DrZedEau/NavBridge_CM4/hardware/NavBridge_CM4/production/bom.csv

Designator | Footprint | Quantity | Value | LCSC Part #
C1 | CP_Elec_6.3x5.8 | 1 | 100µ | C128464
C10, C7, C8, C9 | 1206 | 4 | 47µ | C96123
C11, C15, C29 | 0805 | 3 | 4.7µ | C1779
C12, C13, C14, C18, C19, C20, C21, C23, C24, C26, C27, C30, C32, C33, C34, C35, C37, C38, C39, C4, C40, C43, C44, C45, C47, C49, C5, C53, C6, C62 | 0402 | 30 | 100n | C307331
C16, C46, C48 | 0805 | 3 | 10µ | C15850
C17, C22 | 0402 | 2 | 10n | C15195
C2, C3 | 1206 | 2 | 4.7µ | C29823
C25, C31, C61 | 0402 | 3 | 4.7µ | C23733
C28 | 1206 | 1 | 10µ | C13585
C36, C52, C54, C55, C58, C63, C64, C65, C71 | 0402 | 9 | 1µ | C52923
C41, C42 | 0402 | 2 | 10p | C32949
C50, C51 | 1206 | 2 | 22µ | C12891
C56, C57 | 0402 | 2 | 22p | C1555
C59, C60 | 0402 | 2 | 100p | C1546
C66, C68 | CP_EIA-3528-21_Kemet-B | 2 | 100µ | C16133
C67, C69 | 0402 | 2 | 22n | C1532
C70 | 0603 | 1 | 10µ | C96446
C72 | 0603 | 1 | 10µ | C19702
CN1, CN2 | Hirose_DF40C-100DS-0.4V_2x50_P0.4mm | 2 | DF40C-100DS-0.4V | C597931
CN3 | C277636_CONN-TH_12P-P3_00-S3_00_L12_2-W21_7-EH10_7 | 1 | Molex 430451200 | C277636
CN4 | PinHeader_2x09_P2.54mm_Horizontal | 1 | X1313 Car connector | C492437
CN5 | C598547_IDC-SMD_10P-P1_27_X1270WVS-2X05B-6TV01 | 1 | 20021521-00010C1LF | C598547
CN6, CN7 | C2977809_PCIE-SMD_2199230-4 | 2 | 2199230-4_C2977809 | C2977809
CN8 | C161690_CONN-SMD_2P-P1_25_BM02B-GHS-TBT-LF-SN | 1 | BM02B-GHS-TBT (LF)(SN) | C161690
D1 | 0805 | 1 | LED_G | C2297
D2 | 0805 | 1 | LED_R | C84256
D3 | D_SMC | 1 | SMCJ24A | C19077604
D4 | D_SMA | 1 | SS54 | C22452
D5 | D_SOD-123 | 1 | 1N4148W | C81598
D6 | 0603 | 1 | LED_Y | C89811
FB1 | 0603 | 1 | FerriteBead | C14709
FH1 | C108518_FUSE-SMD_L9_8-W5_0_01550900M | 1 | 01550900M | C108518
J1 | USB_C_Receptacle_G-Switch_GT-USB-7010ASV | 1 | USB_C_Receptacle_USB2.0_16P | C2988369
L1 | L_Sunlord_MWSA1003S | 1 | 6.8uH | C2453947
L2 | L_Sunlord_MWSA0518S | 1 | 6.8uH | C2928918
L3 | 1008 | 1 | 1µH | C435392
R1, R16, R17, R18, R2, R40 | 0402 | 6 | 1k | C11702
R10 | 0603 | 1 | 560 | C23204
R11, R15, R19, R25, R26, R27, R28, R29, R3 | 0402 | 9 | 10k | C25744
R12, R13, R14 | 0402 | 3 | 75 | C25133
R20, R21, R22, R23, R42, R5 | 0402 | 6 | 100k | C25741
R24 | 0402 | 1 | 12K | C25752
R30, R31 | 0402 | 2 | 22 | C25092
R32 | 0402 | 1 | 1.5k | C25867
R33 | 0402 | 1 | 1M | C26083
R34, R35, R37, R38 | 0402 | 4 | 3.3k | C25890
R36, R39 | 0603 | 2 | 15 | C22810
R4 | 0402 | 1 | 49.9k | C25897
R6, R8, R9 | 0402 | 3 | 5.1k | C25905
R7 | 0402 | 1 | 18k | C25762
SW1 | C3312309_SW-SMD_NIDEC_CHS-01B1 | 1 | CHS-01B1 | C3312309
SW2 | SW_SPST_TS-1088-xR020 | 1 | SW_Push | C318884
SW3 | SW_SPST_TS-1088-xR020 | 1 | SW_Push | C720477
U1 | C514175_CONN-TH_SM03B-GHS-TB-LF-SN | 1 | SM03B-GHS | C514175
U10, U8 | C5225740_DFN-8_L3_0-W3_0-P0_65-BL-EP-1 | 2 | ATA663231-GBQW | C5225740
U11, U4 | C22399676_SOT-583-8_L2_1-W1_2-P0_50-LS1_6-BL | 2 | TPS2117DRLR | C22399676
U12 | C128396_UQFN-10_L2_0-W1_5-P0_50-BL | 1 | TS3USB221ARSER | C128396
U13 | C58940_TQFN-36_L6_0-W6_0-P0_50-BL-EP3_7 | 1 | USB2514BI-AEZG-TR | C58940
U14 | C475497_TQFP-32_L7_0-W7_0-P0_80-LS9_0-TL | 1 | PCM2912APJTR | C475497
U15 | C24593_SOT-23-5_L3_0-W1_7-P0_95-LS2_8-BR | 1 | TPS2051BDBVR | C24593
U16 | TSOT-23-6 | 1 | AP63203WU | C780769
U17 | C33770534_DFN-8_L3_0-W2_0-P0_50-BL-EP1_6 | 1 | MFI343S00177-L | C33770534
U18 | C5468341_FPC-SMD_22P-P0_50_0524352271 | 1 | 0524352271 | C5468341
U2 | C189893_CONN-SMD_SM02B-GHS-TB-LF-SN | 1 | SM02B-GHS | C189893
U3 | C485817_SO-8_L4_9-W3_9-P1_27-LS6_0-BL-EP | 1 | LMR14030SQDDARQ1 | C485817
U5 | C404027_SOT-23-5_L3_0-W1_7-P0_95-LS2_8-BR | 1 | TLV75533PDBVR | C404027
U6 | LQFP-48_L7.0-W7.0-P0.50-LS9.0-BL | 1 | ADV7125KSTZ140 | C9668
U7 | C2673443_TSSOP-16_L5_0-W4_4-P0_65-LS6_4-BL | 1 | TMUX1574PWR | C2673443
U9 | LQFP-32_7x7mm_P0.8mm | 1 | STM32C071KBTx | C42116633
Y1 | Crystal_SMD_2016-4Pin_2.0x1.6mm | 1 | Crystal_GND24 | C6616880
Y2 | Crystal_SMD_FOX_FQ7050-4Pin_7.0x5.0mm | 1 | 6MHz | C179631
