DrZedEau/NavBridge_CM4/hardware/NavBridge_CM4/NavBridge_CM4.kicad_pcb

## KiCad design hardware/NavBridge_CM4/NavBridge_CM4.kicad_pcb (2026-11-06)

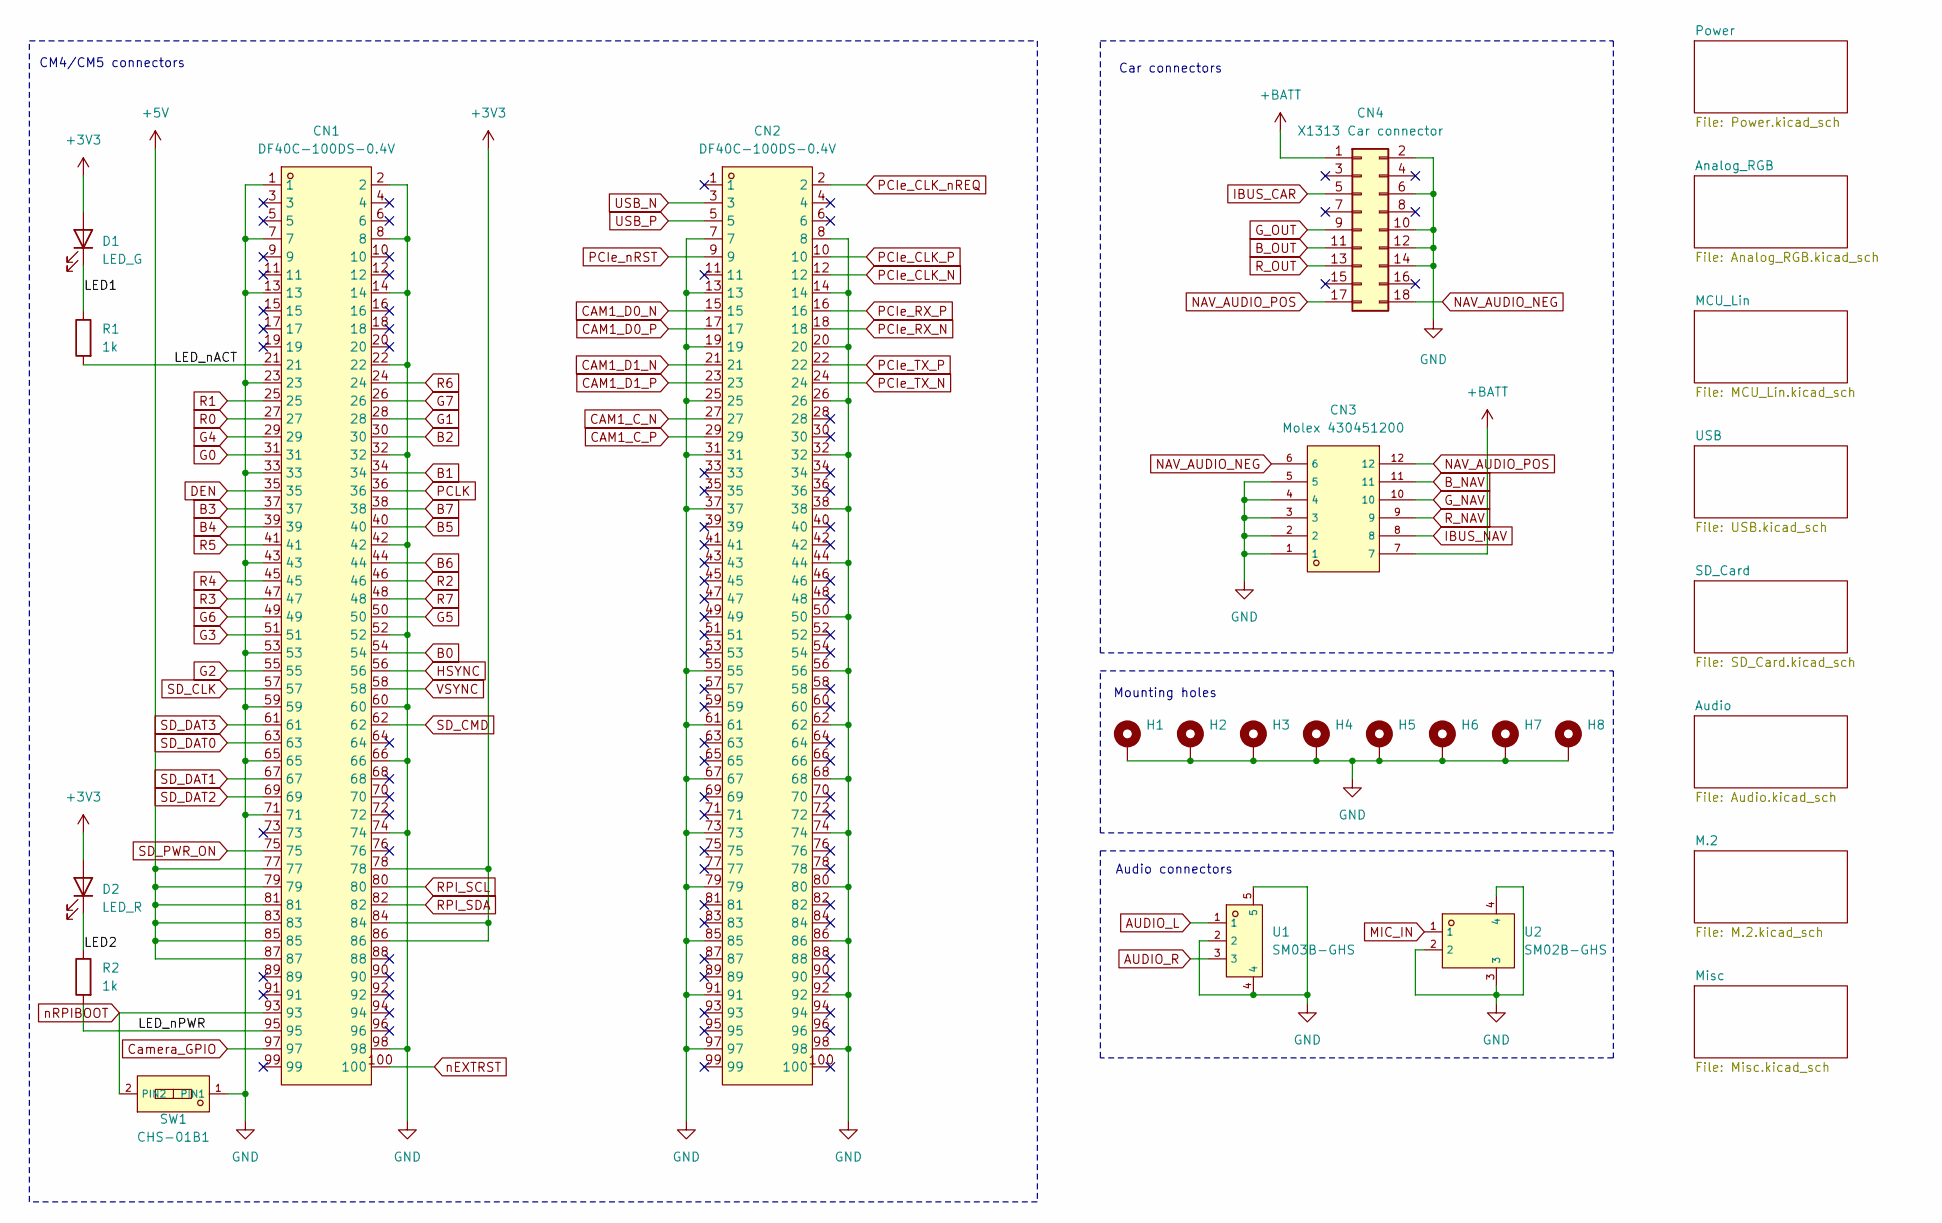
[picture p4: schematic NavBridge_CM4.kicad_sch, CM5_BMW_NavBridge]

Parts:
CN1, CN2: DF40C-100DS-0.4V; Hirose_DF40C-100DS-0.4V_2x50_P0.4mm; LCSC Part C597931
CN3: Molex 430451200; C277636_CONN-TH_12P-P3_00-S3_00_L12_2-W21_7-EH10_7; LCSC C277636
CN4: X1313 Car connector; PinHeader_2x09_P2.54mm_Horizontal; LCSC C492437
D1: LED_G; LED_0805_2012Metric; LCSC C2297
D2: LED_R; LED_0805_2012Metric; LCSC C84256
H1, H2, H3, H4, H5, H6, H7, H8: MountingHole_Pad; MountingHole_2.7mm_M2.5_Pad_TopBottom
R1, R2: 1k; R_0402_1005Metric; LCSC C11702
SW1: CHS-01B1; C3312309_SW-SMD_NIDEC_CHS-01B1; LCSC C3312309
U1: SM03B-GHS; C514175_CONN-TH_SM03B-GHS-TB-LF-SN; LCSC C514175
U2: SM02B-GHS; C189893_CONN-SMD_SM02B-GHS-TB-LF-SN; LCSC C189893

Connections:
+3V3: CN1.78, CN1.84, CN1.86, D1.2 (A), D2.2 (A); also elsewhere on the board
+5V: CN1.77, CN1.79, CN1.81, CN1.83, CN1.85, CN1.87; also elsewhere on the board
+BATT: CN3.7, CN4.1; also elsewhere on the board
/LED1: D1.1 (K), R1.1
/LED2: D2.1 (K), R2.1
/LED_nACT: CN1.21, R1.2
/LED_nPWR: CN1.95, R2.2
AUDIO_L: U1.1; also elsewhere on the board
AUDIO_R: U1.3; also elsewhere on the board
B0: CN1.54; also elsewhere on the board
B1: CN1.34; also elsewhere on the board
B2: CN1.30; also elsewhere on the board
B3: CN1.37; also elsewhere on the board
B4: CN1.39; also elsewhere on the board
B5: CN1.40; also elsewhere on the board
B6: CN1.44; also elsewhere on the board
B7: CN1.38; also elsewhere on the board
B_NAV: CN3.11; also elsewhere on the board
B_OUT: CN4.11; also elsewhere on the board
CAM1_C_N: CN2.27; also elsewhere on the board
CAM1_C_P: CN2.29; also elsewhere on the board
CAM1_D0_N: CN2.15; also elsewhere on the board
CAM1_D0_P: CN2.17; also elsewhere on the board
CAM1_D1_N: CN2.21; also elsewhere on the board
CAM1_D1_P: CN2.23; also elsewhere on the board
Camera_GPIO: CN1.97; also elsewhere on the board
DEN: CN1.35; also elsewhere on the board
G0: CN1.31; also elsewhere on the board
G1: CN1.28; also elsewhere on the board
G2: CN1.55; also elsewhere on the board
G3: CN1.51; also elsewhere on the board
G4: CN1.29; also elsewhere on the board
G5: CN1.50; also elsewhere on the board
G6: CN1.49; also elsewhere on the board
G7: CN1.26; also elsewhere on the board
GND: CN1.1, CN1.2, CN1.7, CN1.8, CN1.13, CN1.14, CN1.22, CN1.23, CN1.32, CN1.33, CN1.42, CN1.43, CN1.52, CN1.53, CN1.59, CN1.60, CN1.65, CN1.66, CN1.71, CN1.74, CN1.98, CN2.7, CN2.8, CN2.13, CN2.14, CN2.19, CN2.20, CN2.25, CN2.26, CN2.31, CN2.32, CN2.37, CN2.38, CN2.44, CN2.50, CN2.55, CN2.56, CN2.61, CN2.62, CN2.67, CN2.68, CN2.73, CN2.74, CN2.79, CN2.80, CN2.85, CN2.86, CN2.91, CN2.92, CN2.97, CN2.98, CN3.1, CN3.2, CN3.3, CN3.4, CN3.5, CN4.2, CN4.6, CN4.10, CN4.12, CN4.14, H1.1 (1_1), H2.1 (1_1), H3.1 (1_1), H4.1 (1_1), H5.1 (1_1), H6.1 (1_1), H7.1 (1_1), H8.1 (1_1), SW1.1 (PIN1), U1.2, U1.4, U1.5, U2.2, U2.3, U2.4; also elsewhere on the board
G_NAV: CN3.10; also elsewhere on the board
G_OUT: CN4.9; also elsewhere on the board
HSYNC: CN1.56; also elsewhere on the board
IBUS_CAR: CN4.5; also elsewhere on the board
IBUS_NAV: CN3.8; also elsewhere on the board
MIC_IN: U2.1; also elsewhere on the board
NAV_AUDIO_NEG: CN3.6, CN4.18
NAV_AUDIO_POS: CN3.12, CN4.17
PCIe_CLK_N: CN2.12; also elsewhere on the board
PCIe_CLK_P: CN2.10; also elsewhere on the board
PCIe_CLK_nREQ: CN2.2; also elsewhere on the board
PCIe_RX_N: CN2.18; also elsewhere on the board
PCIe_RX_P: CN2.16; also elsewhere on the board
PCIe_TX_N: CN2.24; also elsewhere on the board
PCIe_TX_P: CN2.22; also elsewhere on the board
PCIe_nRST: CN2.9; also elsewhere on the board
PCLK: CN1.36; also elsewhere on the board
R0: CN1.27; also elsewhere on the board
R1: CN1.25; also elsewhere on the board
R2: CN1.46; also elsewhere on the board
R3: CN1.47; also elsewhere on the board
R4: CN1.45; also elsewhere on the board
R5: CN1.41; also elsewhere on the board
R6: CN1.24; also elsewhere on the board
R7: CN1.48; also elsewhere on the board
RPI_SCL: CN1.80; also elsewhere on the board
RPI_SDA: CN1.82; also elsewhere on the board
R_NAV: CN3.9; also elsewhere on the board
R_OUT: CN4.13; also elsewhere on the board
SD_CLK: CN1.57
SD_CMD: CN1.62
SD_DAT0: CN1.63
SD_DAT1: CN1.67
SD_DAT2: CN1.69
SD_DAT3: CN1.61
SD_PWR_ON: CN1.75
USB_N: CN2.3; also elsewhere on the board
USB_P: CN2.5; also elsewhere on the board
VSYNC: CN1.58; also elsewhere on the board
nEXTRST: CN1.100; also elsewhere on the board
nRPIBOOT: CN1.93, SW1.2 (PIN2); also elsewhere on the board

Notes on the sheet:
Car connectors
Audio connectors
CM4/CM5 connectors
Mounting holes

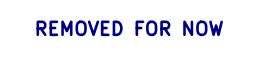
[picture p5: schematic SD_Card.kicad_sch]

Notes on the sheet:
REMOVED FOR NOW

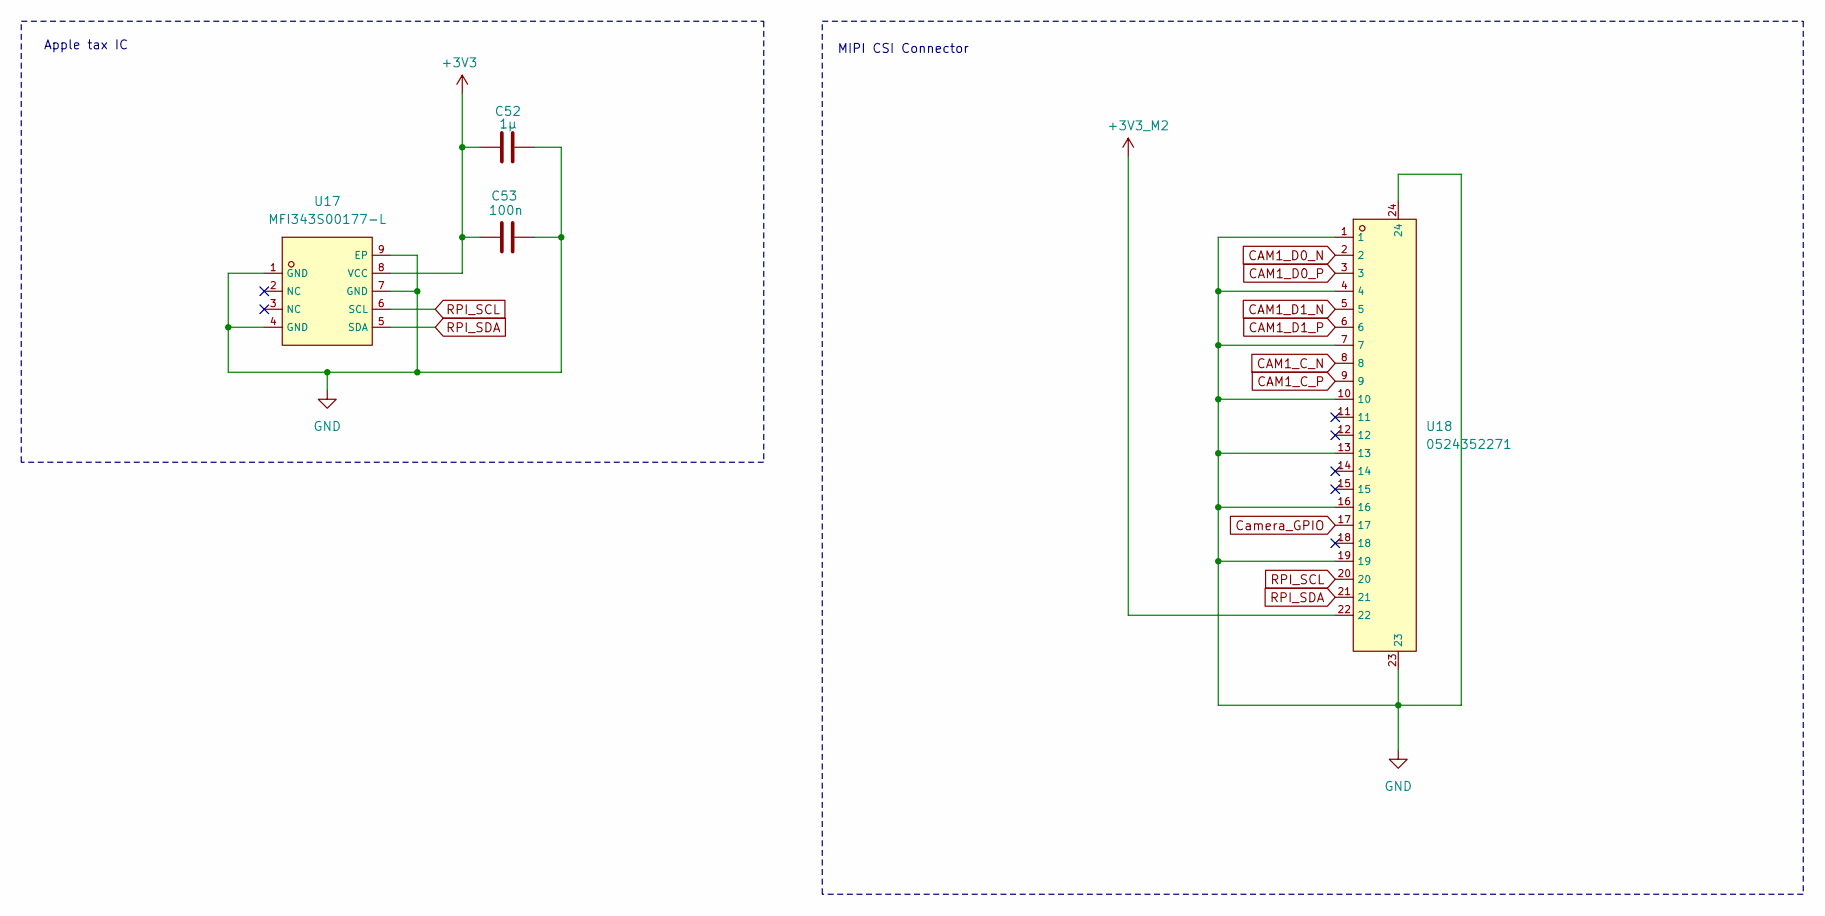
[picture p6: schematic Misc.kicad_sch]

Parts:
C52: 1µ; C_0402_1005Metric; LCSC C52923
C53: 100n; C_0402_1005Metric; LCSC C307331
U17: MFI343S00177-L; C33770534_DFN-8_L3_0-W2_0-P0_50-BL-EP1_6; LCSC C33770534
U18: 0524352271; C5468341_FPC-SMD_22P-P0_50_0524352271; LCSC C5468341

Connections:
+3V3: C52.1, C53.1, U17.8 (VCC); also elsewhere on the board
+3V3_M2: U18.22; also elsewhere on the board
CAM1_C_N: U18.8; also elsewhere on the board
CAM1_C_P: U18.9; also elsewhere on the board
CAM1_D0_N: U18.2; also elsewhere on the board
CAM1_D0_P: U18.3; also elsewhere on the board
CAM1_D1_N: U18.5; also elsewhere on the board
CAM1_D1_P: U18.6; also elsewhere on the board
Camera_GPIO: U18.17; also elsewhere on the board
GND: C52.2, C53.2, U17.1 (GND), U17.4 (GND), U17.7 (GND), U17.9 (EP), U18.1, U18.4, U18.7, U18.10, U18.13, U18.16, U18.19, U18.23, U18.24; also elsewhere on the board
RPI_SCL: U17.6 (SCL), U18.20; also elsewhere on the board
RPI_SDA: U17.5 (SDA), U18.21; also elsewhere on the board

Notes on the sheet:
Apple tax IC
MIPI CSI Connector

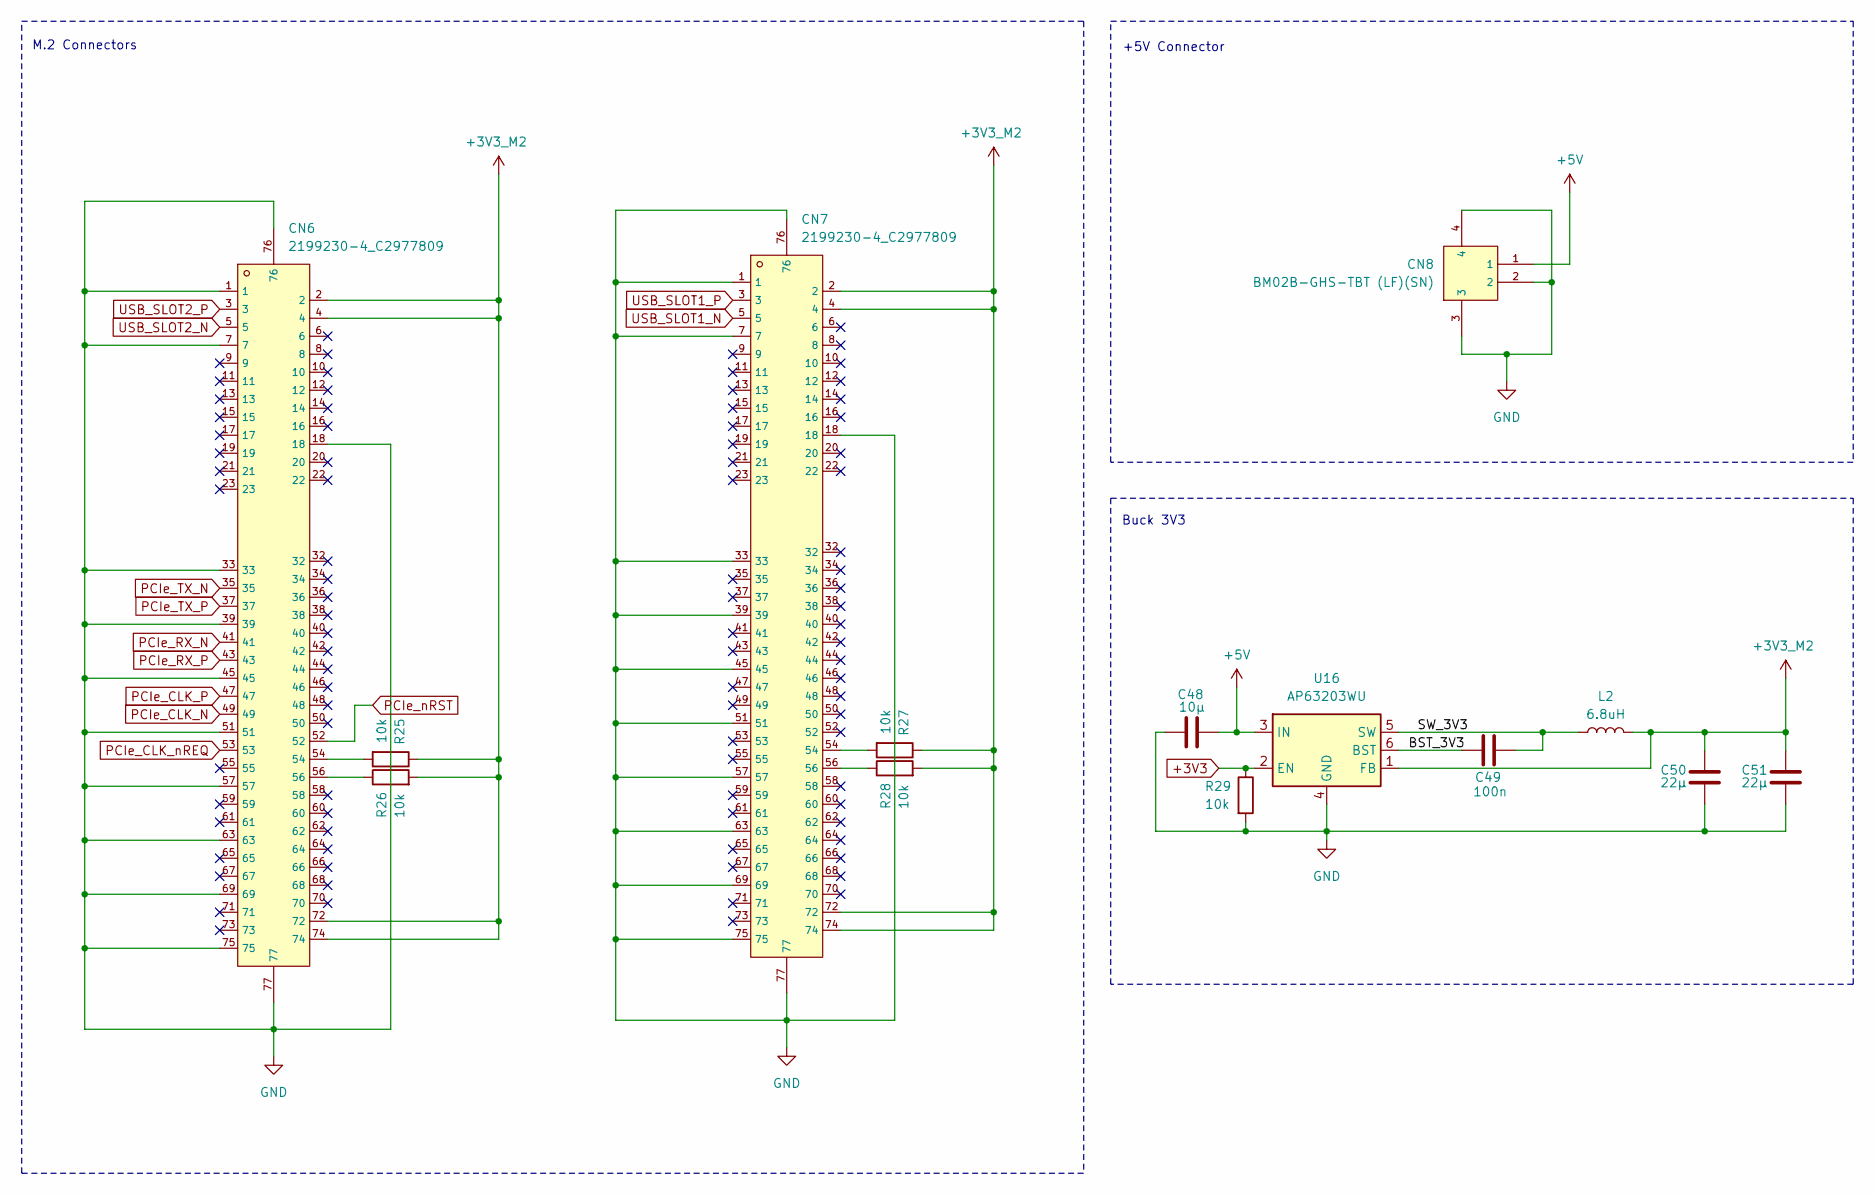
[picture p7: schematic M.2.kicad_sch]

Parts:
C48: 10µ; C_0805_2012Metric; LCSC C15850
C49: 100n; C_0402_1005Metric; LCSC C307331
C50, C51: 22µ; C_1206_3216Metric; LCSC C12891
CN6, CN7: 2199230-4_C2977809; C2977809_PCIE-SMD_2199230-4; LCSC C2977809
CN8: BM02B-GHS-TBT (LF)(SN); C161690_CONN-SMD_2P-P1_25_BM02B-GHS-TBT-LF-SN; LCSC C161690
L2: 6.8uH; L_Sunlord_MWSA0518S; LCSC C2928918
R25, R26, R27, R28, R29: 10k; R_0402_1005Metric; LCSC C25744
U16: AP63203WU; TSOT-23-6; LCSC C780769

Connections:
+3V3: R29.1, U16.2 (EN); also elsewhere on the board
+3V3_M2: C50.1, C51.1, CN6.2, CN6.4, CN6.72, CN6.74, CN7.2, CN7.4, CN7.72, CN7.74, L2.2, R25.1, R26.2, R27.1, R28.2, U16.1 (FB); also elsewhere on the board
+5V: C48.2, CN8.1, U16.3 (IN); also elsewhere on the board
/M.2/BST_3V3: C49.1, U16.6 (BST)
/M.2/SW_3V3: C49.2, L2.1, U16.5 (SW)
GND: C48.1, C50.2, C51.2, CN6.1, CN6.7, CN6.18, CN6.33, CN6.39, CN6.45, CN6.51, CN6.57, CN6.63, CN6.69, CN6.75, CN6.76, CN6.77, CN7.1, CN7.7, CN7.18, CN7.33, CN7.39, CN7.45, CN7.51, CN7.57, CN7.63, CN7.69, CN7.75, CN7.76, CN7.77, CN8.2, CN8.3, CN8.4, R29.2, U16.4 (GND); also elsewhere on the board
unnamed: CN6.54, R25.2
unnamed: CN6.56, R26.1
unnamed: CN7.54, R27.2
unnamed: CN7.56, R28.1
PCIe_CLK_N: CN6.49; also elsewhere on the board
PCIe_CLK_P: CN6.47; also elsewhere on the board
PCIe_CLK_nREQ: CN6.53; also elsewhere on the board
PCIe_RX_N: CN6.41; also elsewhere on the board
PCIe_RX_P: CN6.43; also elsewhere on the board
PCIe_TX_N: CN6.35; also elsewhere on the board
PCIe_TX_P: CN6.37; also elsewhere on the board
PCIe_nRST: CN6.52; also elsewhere on the board
USB_SLOT1_N: CN7.5; also elsewhere on the board
USB_SLOT1_P: CN7.3; also elsewhere on the board
USB_SLOT2_N: CN6.5; also elsewhere on the board
USB_SLOT2_P: CN6.3; also elsewhere on the board

Notes on the sheet:
M.2 Connectors
Buck 3V3
+5V Connector

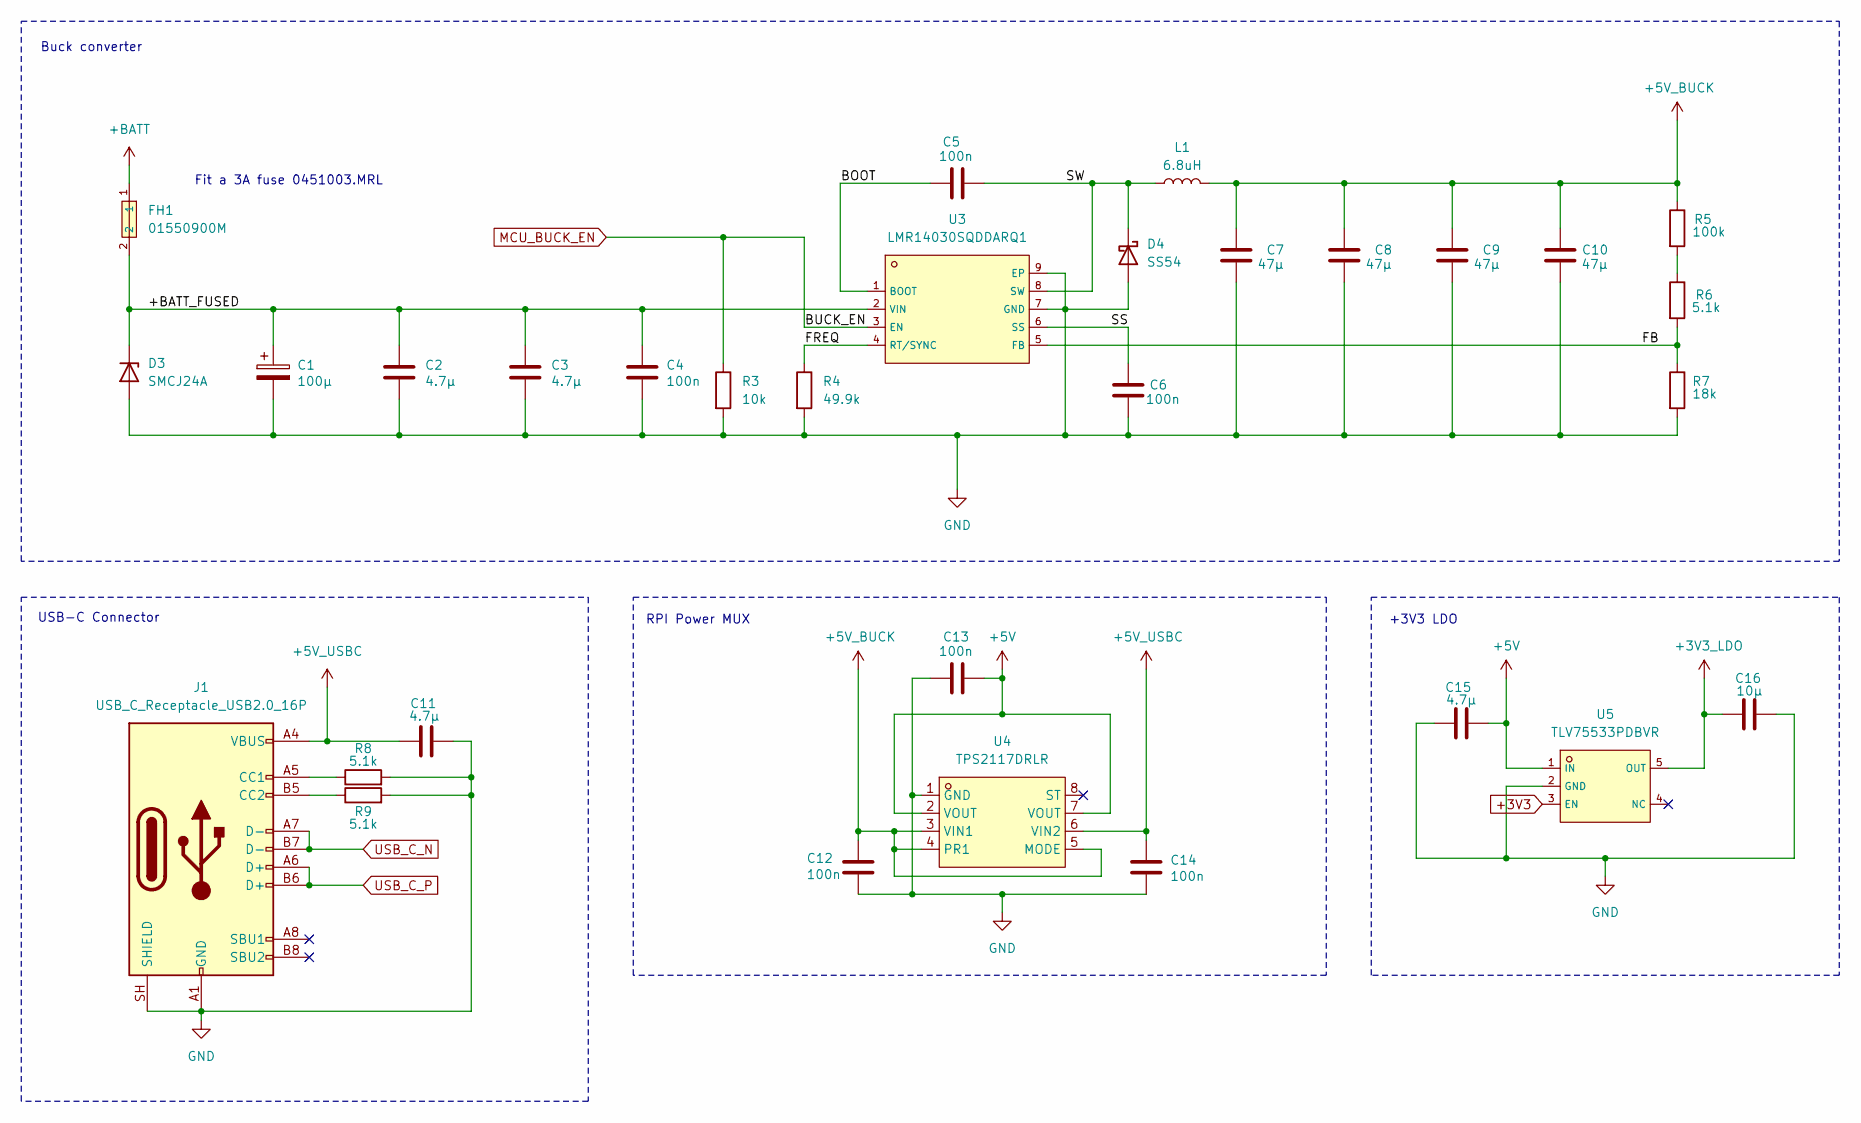
[picture p8: schematic Power.kicad_sch]

Parts:
C1: 100µ; CP_Elec_6.3x5.8; LCSC C128464
C2, C3: 4.7µ; C_1206_3216Metric; LCSC C29823
C4, C5, C6, C12, C13, C14: 100n; C_0402_1005Metric; LCSC C307331
C7, C8, C9, C10: 47µ; C_1206_3216Metric; LCSC C96123
C11, C15: 4.7µ; C_0805_2012Metric; LCSC C1779
C16: 10µ; C_0805_2012Metric; LCSC C15850
D3: SMCJ24A; D_SMC; LCSC C19077604
D4: SS54; D_SMA; LCSC C22452
FH1: 01550900M; C108518_FUSE-SMD_L9_8-W5_0_01550900M; LCSC C108518
J1: USB_C_Receptacle_USB2.0_16P; USB_C_Receptacle_G-Switch_GT-USB-7010ASV; LCSC C2988369
L1: 6.8uH; L_Sunlord_MWSA1003S; LCSC C2453947
R3: 10k; R_0402_1005Metric; LCSC C25744
R4: 49.9k; R_0402_1005Metric; LCSC C25897
R5: 100k; R_0402_1005Metric; LCSC C25741
R6, R8, R9: 5.1k; R_0402_1005Metric; LCSC C25905
R7: 18k; R_0402_1005Metric; LCSC C25762
U3: LMR14030SQDDARQ1; C485817_SO-8_L4_9-W3_9-P1_27-LS6_0-BL-EP; LCSC C485817
U4: TPS2117DRLR; C22399676_SOT-583-8_L2_1-W1_2-P0_50-LS1_6-BL; LCSC Part C22399676
U5: TLV75533PDBVR; C404027_SOT-23-5_L3_0-W1_7-P0_95-LS2_8-BR; LCSC C404027

Connections:
+3V3: U5.3 (EN); also elsewhere on the board
+3V3_LDO: C16.1, U5.5 (OUT); also elsewhere on the board
+5V: C13.2, C15.2, U4.2 (VOUT), U4.7 (VOUT), U5.1 (IN); also elsewhere on the board
+5V_BUCK: C7.1, C8.1, C9.1, C10.1, C12.1, L1.2, R5.1, U4.3 (VIN1), U4.4 (PR1), U4.5 (MODE)
+5V_USBC: C11.1, C14.1, J1.A4 (VBUS), J1.A9 (VBUS), J1.B4 (VBUS), J1.B9 (VBUS), U4.6 (VIN2)
+BATT: FH1.1; also elsewhere on the board
/Power/+BATT_FUSED: C1.1, C2.1, C3.1, C4.1, D3.1 (K), FH1.2, U3.2 (VIN)
/Power/BOOT: C5.1, U3.1 (BOOT)
/Power/FB: R6.2, R7.1, U3.5 (FB)
/Power/FREQ: R4.1, U3.4 (RT/SYNC)
/Power/SS: C6.1, U3.6 (SS)
/Power/SW: C5.2, D4.1 (K), L1.1, U3.8 (SW)
GND: C1.2, C2.2, C3.2, C4.2, C6.2, C7.2, C8.2, C9.2, C10.2, C11.2, C12.2, C13.1, C14.2, C15.1, C16.2, D3.2 (A), D4.2 (A), J1.A1 (GND), J1.A12 (GND), J1.B1 (GND), J1.B12 (GND), J1.SH (SHIELD), R3.2, R4.2, R7.2, R8.2, R9.2, U3.7 (GND), U3.9 (EP), U4.1 (GND), U5.2 (GND); also elsewhere on the board
MCU_BUCK_EN: R3.1, U3.3 (EN); also elsewhere on the board
unnamed: J1.A5 (CC1), R8.1
unnamed: J1.B5 (CC2), R9.1
unnamed: R5.2, R6.1
USB_C_N: J1.A7 (D-), J1.B7 (D-); also elsewhere on the board
USB_C_P: J1.A6 (D+), J1.B6 (D+); also elsewhere on the board

Notes on the sheet:
Buck converter
Fit a 3A fuse 0451003.MRL
USB-C Connector
RPI Power MUX
+3V3 LDO

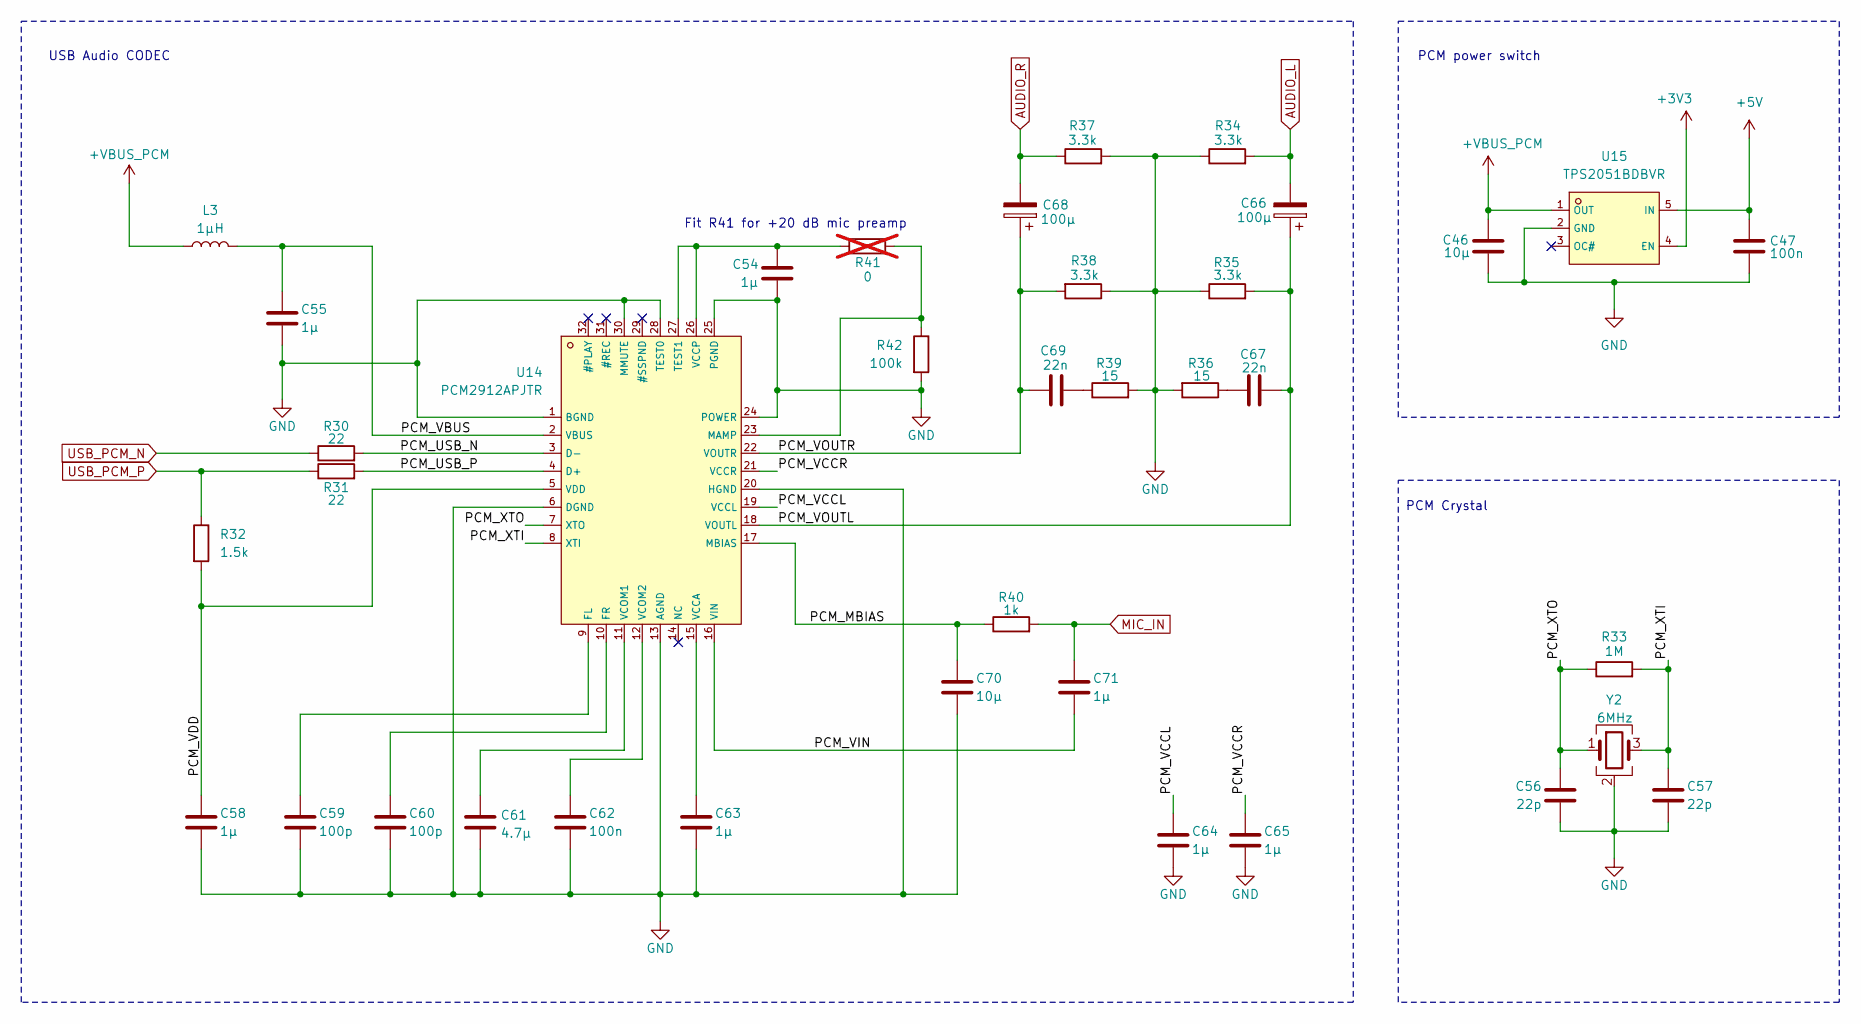
[picture p9: schematic Audio.kicad_sch]

Parts:
C46: 10µ; C_0805_2012Metric; LCSC C15850
C47, C62: 100n; C_0402_1005Metric; LCSC C307331
C54, C55, C58, C63, C64, C65, C71: 1µ; C_0402_1005Metric; LCSC C52923
C56, C57: 22p; C_0402_1005Metric; LCSC C1555
C59, C60: 100p; C_0402_1005Metric; LCSC C1546
C61: 4.7µ; C_0402_1005Metric; LCSC C23733
C66, C68: 100µ; CP_EIA-3528-21_Kemet-B; LCSC C16133
C67, C69: 22n; C_0402_1005Metric; LCSC C1532
C70: 10µ; C_0603_1608Metric; LCSC C96446
L3: 1µH; L_1008_2520Metric; LCSC C435392
R30, R31: 22; R_0402_1005Metric; LCSC C25092
R32: 1.5k; R_0402_1005Metric; LCSC C25867
R33: 1M; R_0402_1005Metric; LCSC C26083
R34, R35, R37, R38: 3.3k; R_0402_1005Metric; LCSC C25890
R36, R39: 15; R_0603_1608Metric; LCSC C22810
R40: 1k; R_0402_1005Metric; LCSC C11702
R41: 0; R_0402_1005Metric; LCSC C17168; not fitted
R42: 100k; R_0402_1005Metric; LCSC C25741
U14: PCM2912APJTR; C475497_TQFP-32_L7_0-W7_0-P0_80-LS9_0-TL; LCSC C475497
U15: TPS2051BDBVR; C24593_SOT-23-5_L3_0-W1_7-P0_95-LS2_8-BR; LCSC C24593
Y2: 6MHz; Crystal_SMD_FOX_FQ7050-4Pin_7.0x5.0mm; LCSC C179631

Connections:
+3V3: U15.4 (EN); also elsewhere on the board
+5V: C47.1, U15.5 (IN); also elsewhere on the board
+VBUS_PCM: C46.2, L3.1, U15.1 (OUT)
/Audio/PCM_MBIAS: C70.1, R40.1, U14.17 (MBIAS)
/Audio/PCM_USB_N: R30.2, U14.3 (D-)
/Audio/PCM_USB_P: R31.2, U14.4 (D+)
/Audio/PCM_VBUS: C55.1, L3.2, U14.2 (VBUS)
/Audio/PCM_VCCL: C64.1, U14.19 (VCCL)
/Audio/PCM_VCCR: C65.1, U14.21 (VCCR)
/Audio/PCM_VDD: C58.1, R32.2, U14.5 (VDD)
/Audio/PCM_VIN: C71.2, U14.16 (VIN)
/Audio/PCM_VOUTL: C66.1, C67.1, R35.2, U14.18 (VOUTL)
/Audio/PCM_VOUTR: C68.1, C69.1, R38.2, U14.22 (VOUTR)
/Audio/PCM_XTI: C57.1, R33.2, U14.8 (XTI), Y2.3
/Audio/PCM_XTO: C56.1, R33.1, U14.7 (XTO), Y2.1
AUDIO_L: C66.2, R34.2; also elsewhere on the board
AUDIO_R: C68.2, R37.1; also elsewhere on the board
GND: C46.1, C47.2, C54.2, C55.2, C56.2, C57.2, C58.2, C59.2, C60.2, C61.2, C62.2, C63.2, C64.2, C65.2, C70.2, R34.1, R35.1, R36.2, R37.2, R38.1, R39.2, R42.2, U14.1 (BGND), U14.6 (DGND), U14.13 (AGND), U14.20 (HGND), U14.24 (POWER), U14.25 (PGND), U14.28 (TEST0), U14.30 (MMUTE), U15.2 (GND), Y2.2 (G), Y2.4 (G); also elsewhere on the board
MIC_IN: C71.1, R40.2; also elsewhere on the board
unnamed: C67.2, R36.1
unnamed: C69.2, R39.1
unnamed: C59.1, U14.9 (FL)
unnamed: C60.1, U14.10 (FR)
unnamed: R41.2, R42.1, U14.23 (MAMP)
unnamed: C54.1, R41.1, U14.26 (VCCP), U14.27 (TEST1)
unnamed: C63.1, U14.15 (VCCA)
unnamed: C61.1, U14.11 (VCOM1)
unnamed: C62.1, U14.12 (VCOM2)
USB_PCM_N: R30.1; also elsewhere on the board
USB_PCM_P: R31.1, R32.1; also elsewhere on the board

Notes on the sheet:
PCM Crystal
Fit R41 for +20 dB mic preamp
USB Audio CODEC
PCM power switch

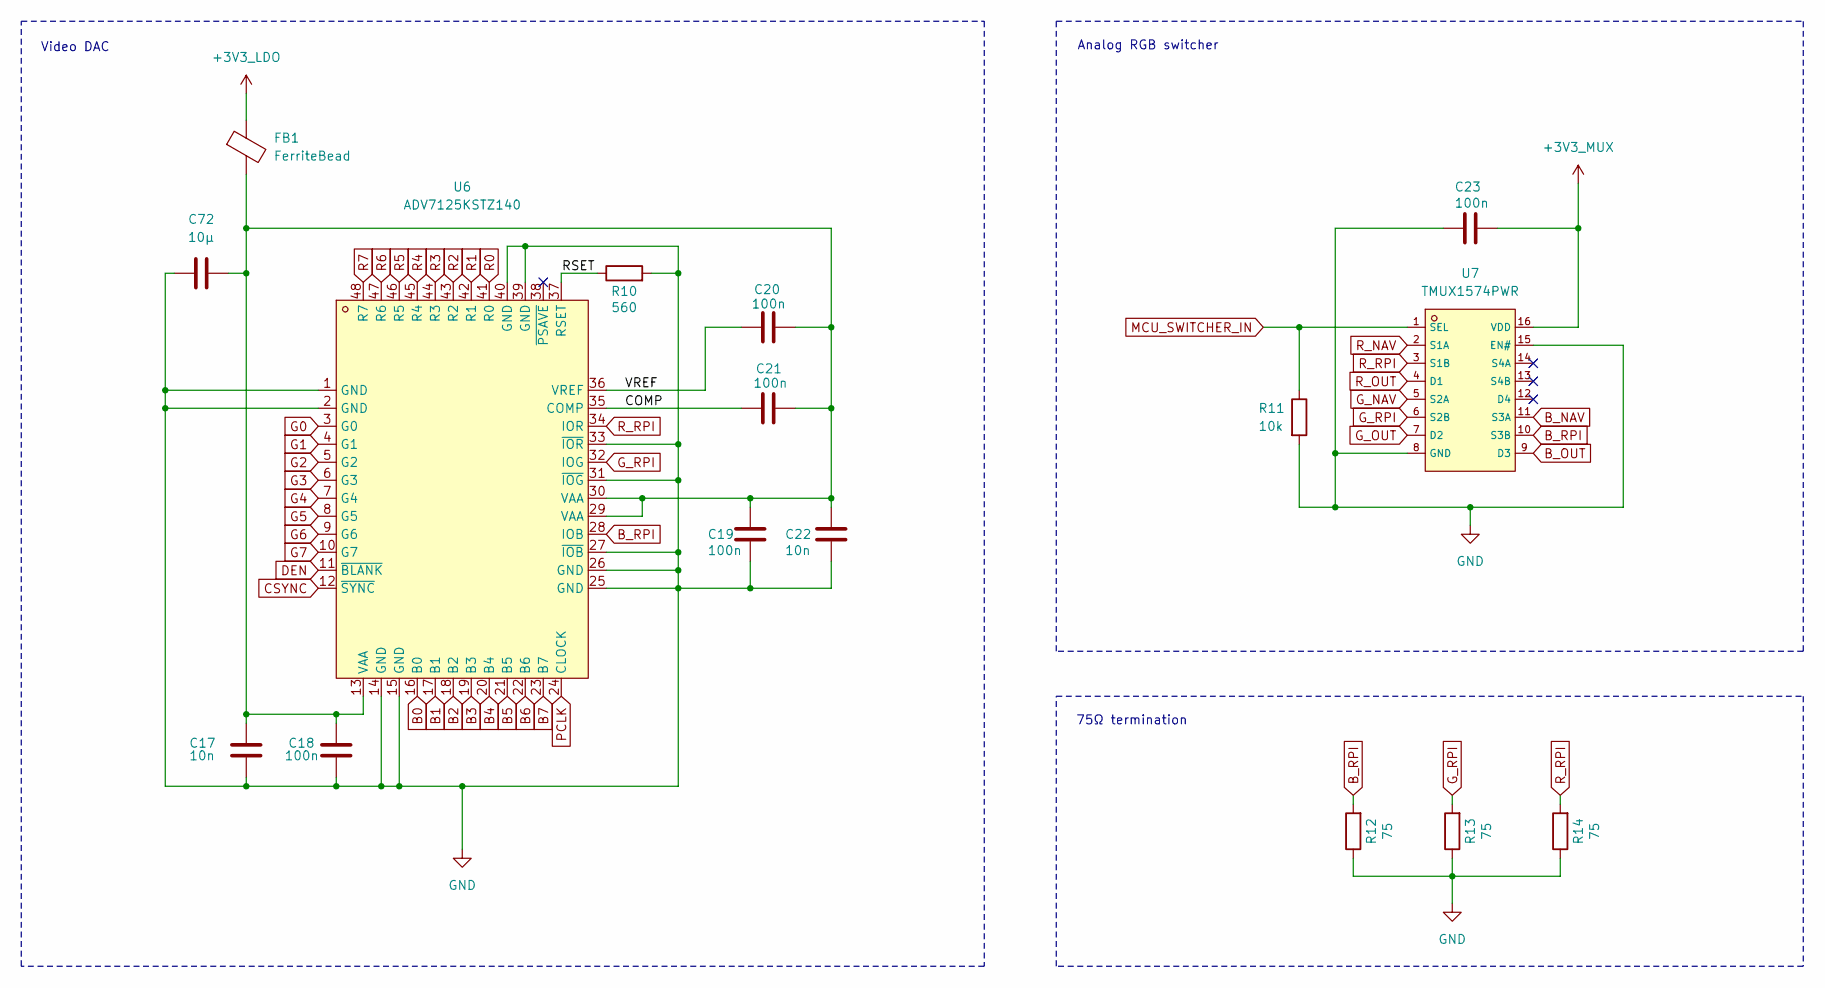
[picture p10: schematic Analog_RGB.kicad_sch]

Parts:
C17, C22: 10n; C_0402_1005Metric; LCSC C15195
C18, C19, C20, C21, C23: 100n; C_0402_1005Metric; LCSC C307331
C72: 10µ; C_0603_1608Metric; LCSC C19702
FB1: FerriteBead; R_0603_1608Metric; LCSC C14709
R10: 560; R_0603_1608Metric; LCSC C23204
R11: 10k; R_0402_1005Metric; LCSC C25744
R12, R13, R14: 75; R_0402_1005Metric; LCSC C25133
U6: ADV7125KSTZ140; LQFP-48_L7.0-W7.0-P0.50-LS9.0-BL; LCSC Part C9668
U7: TMUX1574PWR; C2673443_TSSOP-16_L5_0-W4_4-P0_65-LS6_4-BL; LCSC C2673443

Connections:
+3V3_LDO: FB1.1; also elsewhere on the board
+3V3_MUX: C23.2, U7.16 (VDD); also elsewhere on the board
/Analog_RGB/COMP: C21.2, U6.35 (COMP)
/Analog_RGB/RSET: R10.1, U6.37 (RSET)
/Analog_RGB/VREF: C20.2, U6.36 (VREF)
B0: U6.16 (B0); also elsewhere on the board
B1: U6.17 (B1); also elsewhere on the board
B2: U6.18 (B2); also elsewhere on the board
B3: U6.19 (B3); also elsewhere on the board
B4: U6.20 (B4); also elsewhere on the board
B5: U6.21 (B5); also elsewhere on the board
B6: U6.22 (B6); also elsewhere on the board
B7: U6.23 (B7); also elsewhere on the board
B_NAV: U7.11 (S3A); also elsewhere on the board
B_OUT: U7.9 (D3); also elsewhere on the board
B_RPI: R12.2, U6.28 (IOB), U7.10 (S3B)
CSYNC: U6.12 (~SYNC); also elsewhere on the board
DEN: U6.11 (~BLANK); also elsewhere on the board
G0: U6.3 (G0); also elsewhere on the board
G1: U6.4 (G1); also elsewhere on the board
G2: U6.5 (G2); also elsewhere on the board
G3: U6.6 (G3); also elsewhere on the board
G4: U6.7 (G4); also elsewhere on the board
G5: U6.8 (G5); also elsewhere on the board
G6: U6.9 (G6); also elsewhere on the board
G7: U6.10 (G7); also elsewhere on the board
GND: C17.1, C18.1, C19.1, C22.1, C23.1, C72.1, R10.2, R11.2, R12.1, R13.1, R14.1, U6.1 (GND), U6.2 (GND), U6.14 (GND), U6.15 (GND), U6.25 (GND), U6.26 (GND), U6.27 (~IOB), U6.31 (~IOG), U6.33 (~IOR), U6.39 (GND), U6.40 (GND), U7.8 (GND), U7.15 (EN#); also elsewhere on the board
G_NAV: U7.5 (S2A); also elsewhere on the board
G_OUT: U7.7 (D2); also elsewhere on the board
G_RPI: R13.2, U6.32 (IOG), U7.6 (S2B)
MCU_SWITCHER_IN: R11.1, U7.1 (SEL); also elsewhere on the board
unnamed: C17.2, C18.2, C19.2, C20.1, C21.1, C22.2, C72.2, FB1.2, U6.13 (VAA), U6.29 (VAA), U6.30 (VAA)
PCLK: U6.24 (CLOCK); also elsewhere on the board
R0: U6.41 (R0); also elsewhere on the board
R1: U6.42 (R1); also elsewhere on the board
R2: U6.43 (R2); also elsewhere on the board
R3: U6.44 (R3); also elsewhere on the board
R4: U6.45 (R4); also elsewhere on the board
R5: U6.46 (R5); also elsewhere on the board
R6: U6.47 (R6); also elsewhere on the board
R7: U6.48 (R7); also elsewhere on the board
R_NAV: U7.2 (S1A); also elsewhere on the board
R_OUT: U7.4 (D1); also elsewhere on the board
R_RPI: R14.2, U6.34 (IOR), U7.3 (S1B)

Notes on the sheet:
Video DAC
Analog RGB switcher
75Ω termination
