DrZedEau/NavBridge_CM4/hardware/NavBridge_CM4/NavBridge_CM4.kicad_pcb

## KiCad design hardware/NavBridge_CM4/NavBridge_CM4.kicad_pcb (continued)

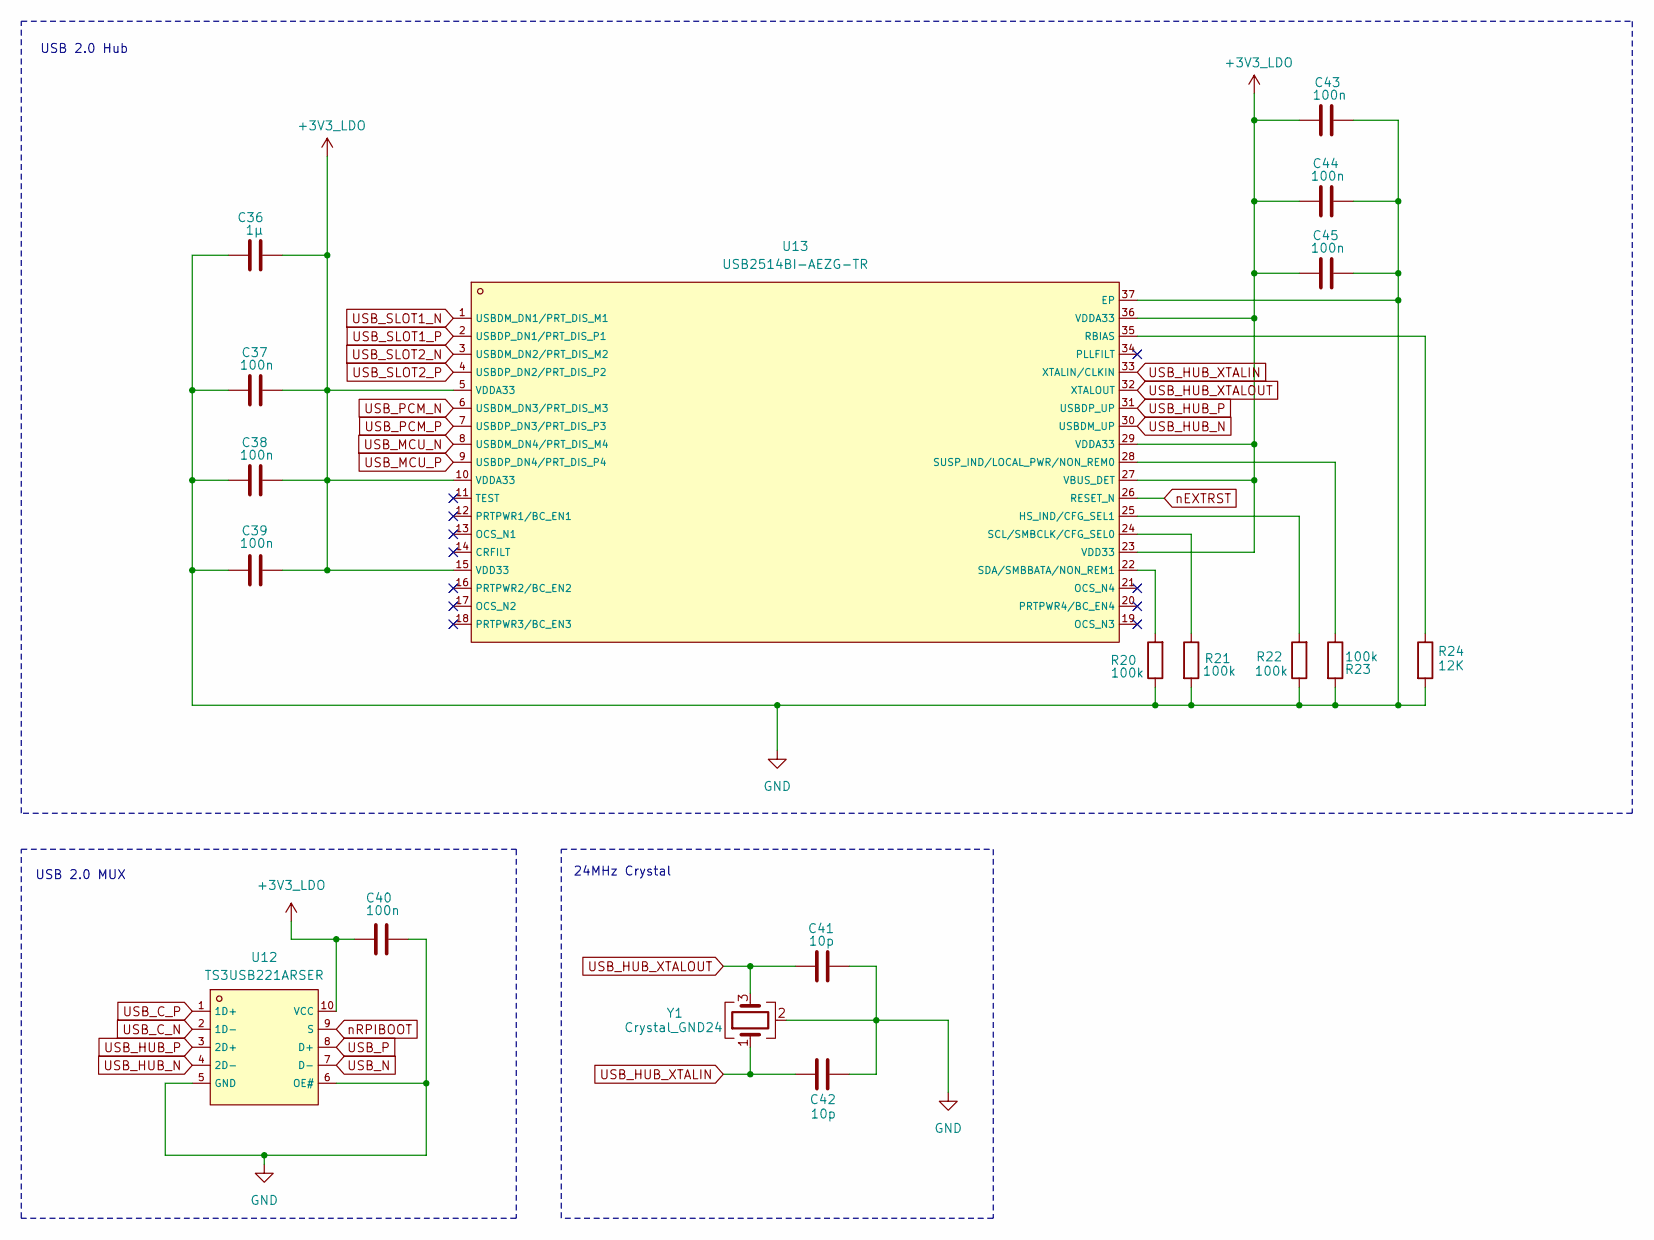
[picture p11: schematic USB.kicad_sch]

Parts:
C36: 1µ; C_0402_1005Metric; LCSC C52923
C37, C38, C39, C40, C43, C44, C45: 100n; C_0402_1005Metric; LCSC C307331
C41, C42: 10p; C_0402_1005Metric; LCSC C32949
R20, R21, R22, R23: 100k; R_0402_1005Metric; LCSC C25741
R24: 12K; R_0402_1005Metric; LCSC C25752
U12: TS3USB221ARSER; C128396_UQFN-10_L2_0-W1_5-P0_50-BL; LCSC C128396
U13: USB2514BI-AEZG-TR; C58940_TQFN-36_L6_0-W6_0-P0_50-BL-EP3_7; LCSC C58940
Y1: Crystal_GND24; Crystal_SMD_2016-4Pin_2.0x1.6mm; LCSC C6616880

Connections:
+3V3_LDO: C36.2, C37.2, C38.2, C39.2, C40.1, C43.1, C44.1, C45.1, U12.10 (VCC), U13.5 (VDDA33), U13.10 (VDDA33), U13.15 (VDD33), U13.23 (VDD33), U13.27 (VBUS_DET), U13.29 (VDDA33), U13.36 (VDDA33); also elsewhere on the board
GND: C36.1, C37.1, C38.1, C39.1, C40.2, C41.2, C42.2, C43.2, C44.2, C45.2, R20.1, R21.2, R22.1, R23.2, R24.2, U12.5 (GND), U12.6 (OE#), U13.37 (EP), Y1.2 (G), Y1.4 (G); also elsewhere on the board
unnamed: R22.2, U13.25 (HS_IND/CFG_SEL1)
unnamed: R24.1, U13.35 (RBIAS)
unnamed: R21.1, U13.24 (SCL/SMBCLK/CFG_SEL0)
unnamed: R20.2, U13.22 (SDA/SMBBATA/NON_REM1)
unnamed: R23.1, U13.28 (SUSP_IND/LOCAL_PWR/NON_REM0)
USB_C_N: U12.2 (1D-); also elsewhere on the board
USB_C_P: U12.1 (1D+); also elsewhere on the board
USB_HUB_N: U12.4 (2D-), U13.30 (USBDM_UP)
USB_HUB_P: U12.3 (2D+), U13.31 (USBDP_UP)
USB_HUB_XTALIN: C42.1, U13.33 (XTALIN/CLKIN), Y1.1
USB_HUB_XTALOUT: C41.1, U13.32 (XTALOUT), Y1.3
USB_MCU_N: U13.8 (USBDM_DN4/PRT_DIS_M4); also elsewhere on the board
USB_MCU_P: U13.9 (USBDP_DN4/PRT_DIS_P4); also elsewhere on the board
USB_N: U12.7 (D-); also elsewhere on the board
USB_P: U12.8 (D+); also elsewhere on the board
USB_PCM_N: U13.6 (USBDM_DN3/PRT_DIS_M3); also elsewhere on the board
USB_PCM_P: U13.7 (USBDP_DN3/PRT_DIS_P3); also elsewhere on the board
USB_SLOT1_N: U13.1 (USBDM_DN1/PRT_DIS_M1); also elsewhere on the board
USB_SLOT1_P: U13.2 (USBDP_DN1/PRT_DIS_P1); also elsewhere on the board
USB_SLOT2_N: U13.3 (USBDM_DN2/PRT_DIS_M2); also elsewhere on the board
USB_SLOT2_P: U13.4 (USBDP_DN2/PRT_DIS_P2); also elsewhere on the board
nEXTRST: U13.26 (RESET_N); also elsewhere on the board
nRPIBOOT: U12.9 (S); also elsewhere on the board

Notes on the sheet:
USB 2.0 Hub
24MHz Crystal
USB 2.0 MUX

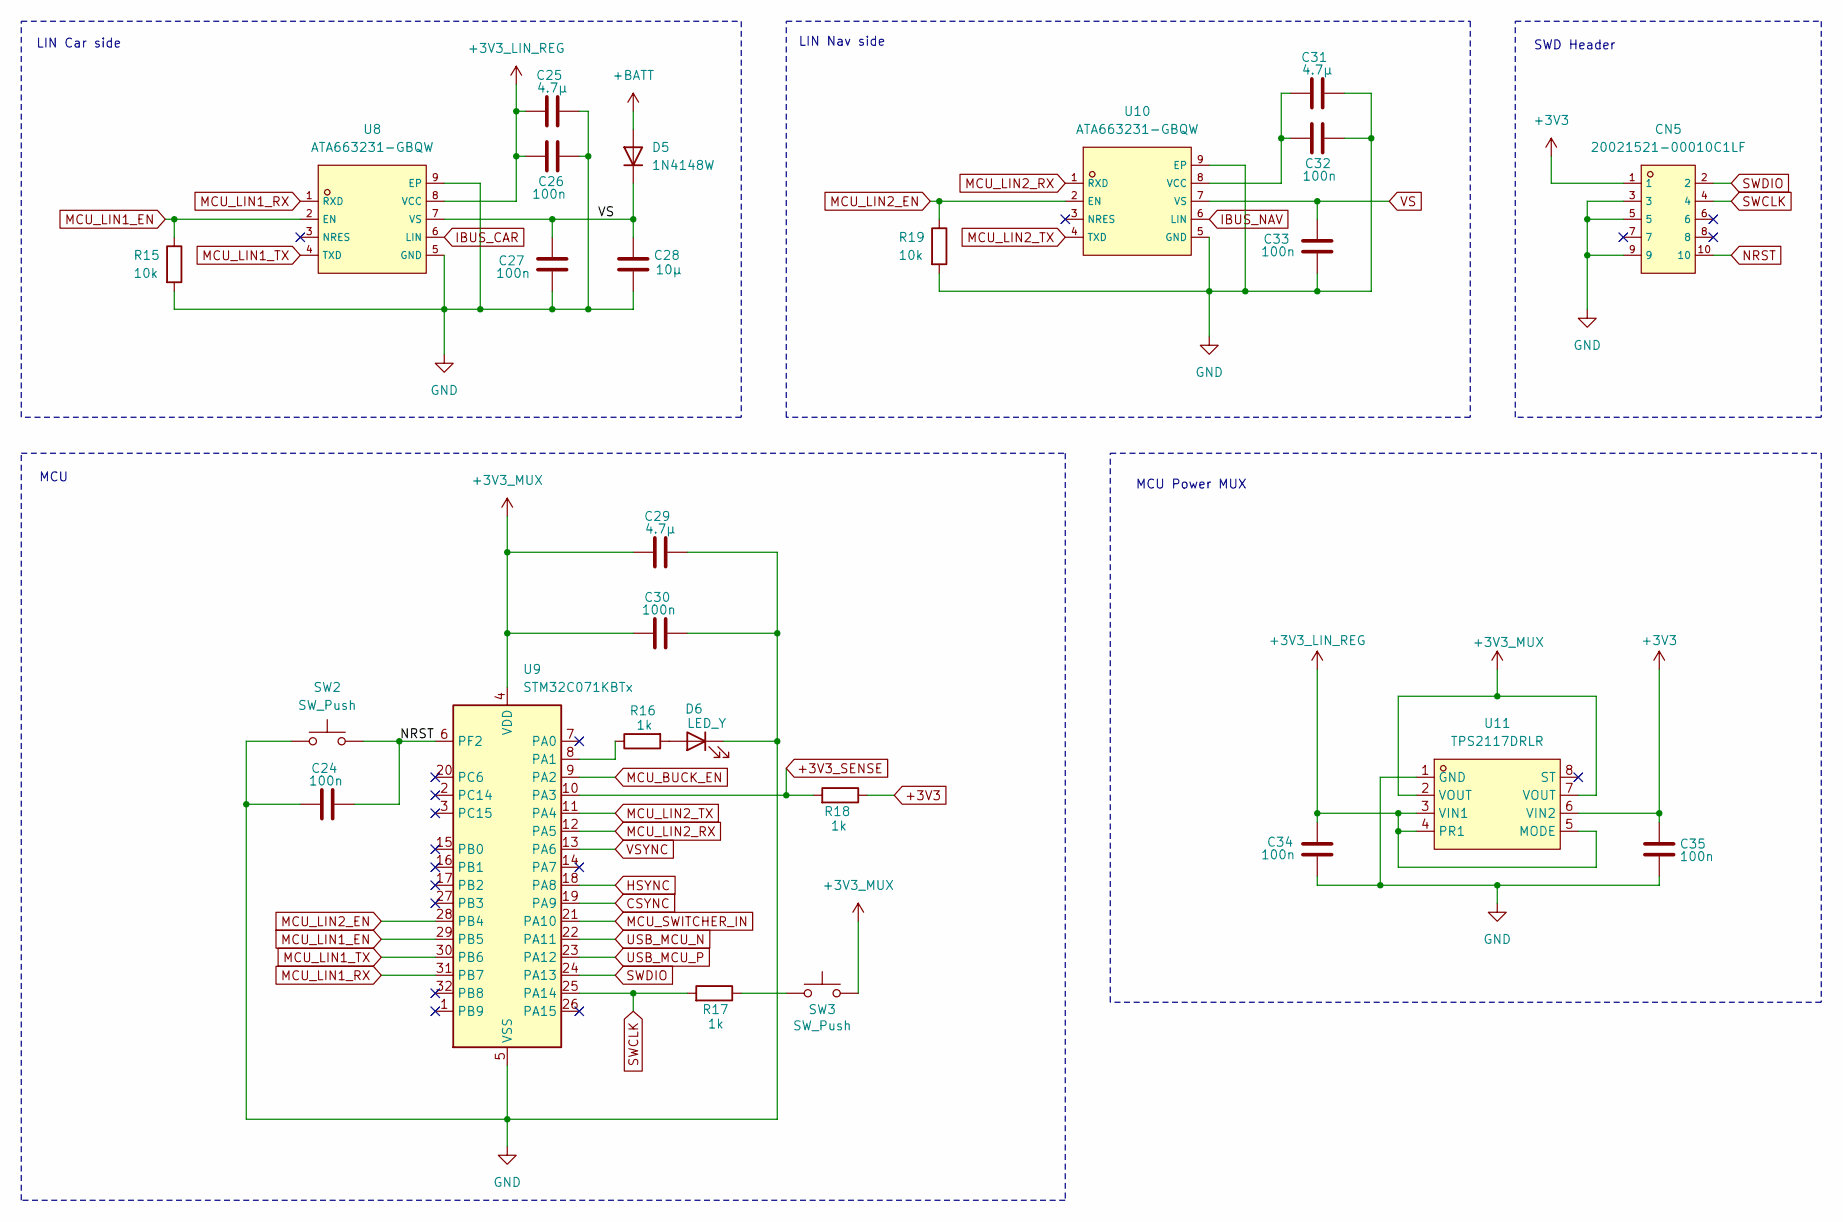
[picture p12: schematic MCU_Lin.kicad_sch]

Parts:
C24, C26, C27, C30, C32, C33, C34, C35: 100n; C_0402_1005Metric; LCSC C307331
C25, C31: 4.7µ; C_0402_1005Metric; LCSC C23733
C28: 10µ; C_1206_3216Metric; LCSC C13585
C29: 4.7µ; C_0805_2012Metric; LCSC C1779
CN5: 20021521-00010C1LF; C598547_IDC-SMD_10P-P1_27_X1270WVS-2X05B-6TV01; LCSC C598547
D5: 1N4148W; D_SOD-123; LCSC C81598
D6: LED_Y; LED_0603_1608Metric; LCSC C89811
R15, R19: 10k; R_0402_1005Metric; LCSC C25744
R16, R17, R18: 1k; R_0402_1005Metric; LCSC C11702
SW2: SW_Push; SW_SPST_TS-1088-xR020; LCSC C318884
SW3: SW_Push; SW_SPST_TS-1088-xR020; LCSC C720477
U8, U10: ATA663231-GBQW; C5225740_DFN-8_L3_0-W3_0-P0_65-BL-EP-1; LCSC C5225740
U9: STM32C071KBTx; LQFP-32_7x7mm_P0.8mm; LCSC C42116633
U11: TPS2117DRLR; C22399676_SOT-583-8_L2_1-W1_2-P0_50-LS1_6-BL; LCSC Part C22399676

Connections:
+3V3: C35.1, CN5.1, R18.1, U11.6 (VIN2); also elsewhere on the board
+3V3_LIN_REG: C25.1, C26.2, C34.2, U8.8 (VCC), U11.3 (VIN1), U11.4 (PR1), U11.5 (MODE)
+3V3_MUX: C29.1, C30.1, SW3.2, U9.4 (VDD), U11.2 (VOUT), U11.7 (VOUT); also elsewhere on the board
+3V3_SENSE: R18.2, U9.10 (PA3)
+BATT: D5.2 (A); also elsewhere on the board
CSYNC: U9.19 (PA9); also elsewhere on the board
GND: C24.1, C25.2, C26.1, C27.1, C28.2, C29.2, C30.2, C31.2, C32.2, C33.1, C34.1, C35.2, CN5.3, CN5.5, CN5.9, D6.1 (K), R15.2, R19.2, SW2.1, U8.5 (GND), U8.9 (EP), U9.5 (VSS), U10.5 (GND), U10.9 (EP), U11.1 (GND); also elsewhere on the board
HSYNC: U9.18 (PA8); also elsewhere on the board
IBUS_CAR: U8.6 (LIN); also elsewhere on the board
IBUS_NAV: U10.6 (LIN); also elsewhere on the board
MCU_BUCK_EN: U9.9 (PA2); also elsewhere on the board
MCU_LIN1_EN: R15.1, U8.2 (EN), U9.29 (PB5)
MCU_LIN1_RX: U8.1 (RXD), U9.31 (PB7)
MCU_LIN1_TX: U8.4 (TXD), U9.30 (PB6)
MCU_LIN2_EN: R19.1, U9.28 (PB4), U10.2 (EN)
MCU_LIN2_RX: U9.12 (PA5), U10.1 (RXD)
MCU_LIN2_TX: U9.11 (PA4), U10.4 (TXD)
MCU_SWITCHER_IN: U9.21 (PA10); also elsewhere on the board
NRST: C24.2, CN5.10, SW2.2, U9.6 (PF2)
unnamed: D6.2 (A), R16.2
unnamed: R17.1, SW3.1
unnamed: R16.1, U9.8 (PA1)
unnamed: C31.1, C32.1, U10.8 (VCC)
SWCLK: CN5.4, R17.2, U9.25 (PA14)
SWDIO: CN5.2, U9.24 (PA13)
USB_MCU_N: U9.22 (PA11); also elsewhere on the board
USB_MCU_P: U9.23 (PA12); also elsewhere on the board
VS: C27.2, C28.1, C33.2, D5.1 (K), U8.7 (VS), U10.7 (VS)
VSYNC: U9.13 (PA6); also elsewhere on the board

Notes on the sheet:
MCU
MCU Power MUX
SWD Header
LIN Nav side
LIN Car side

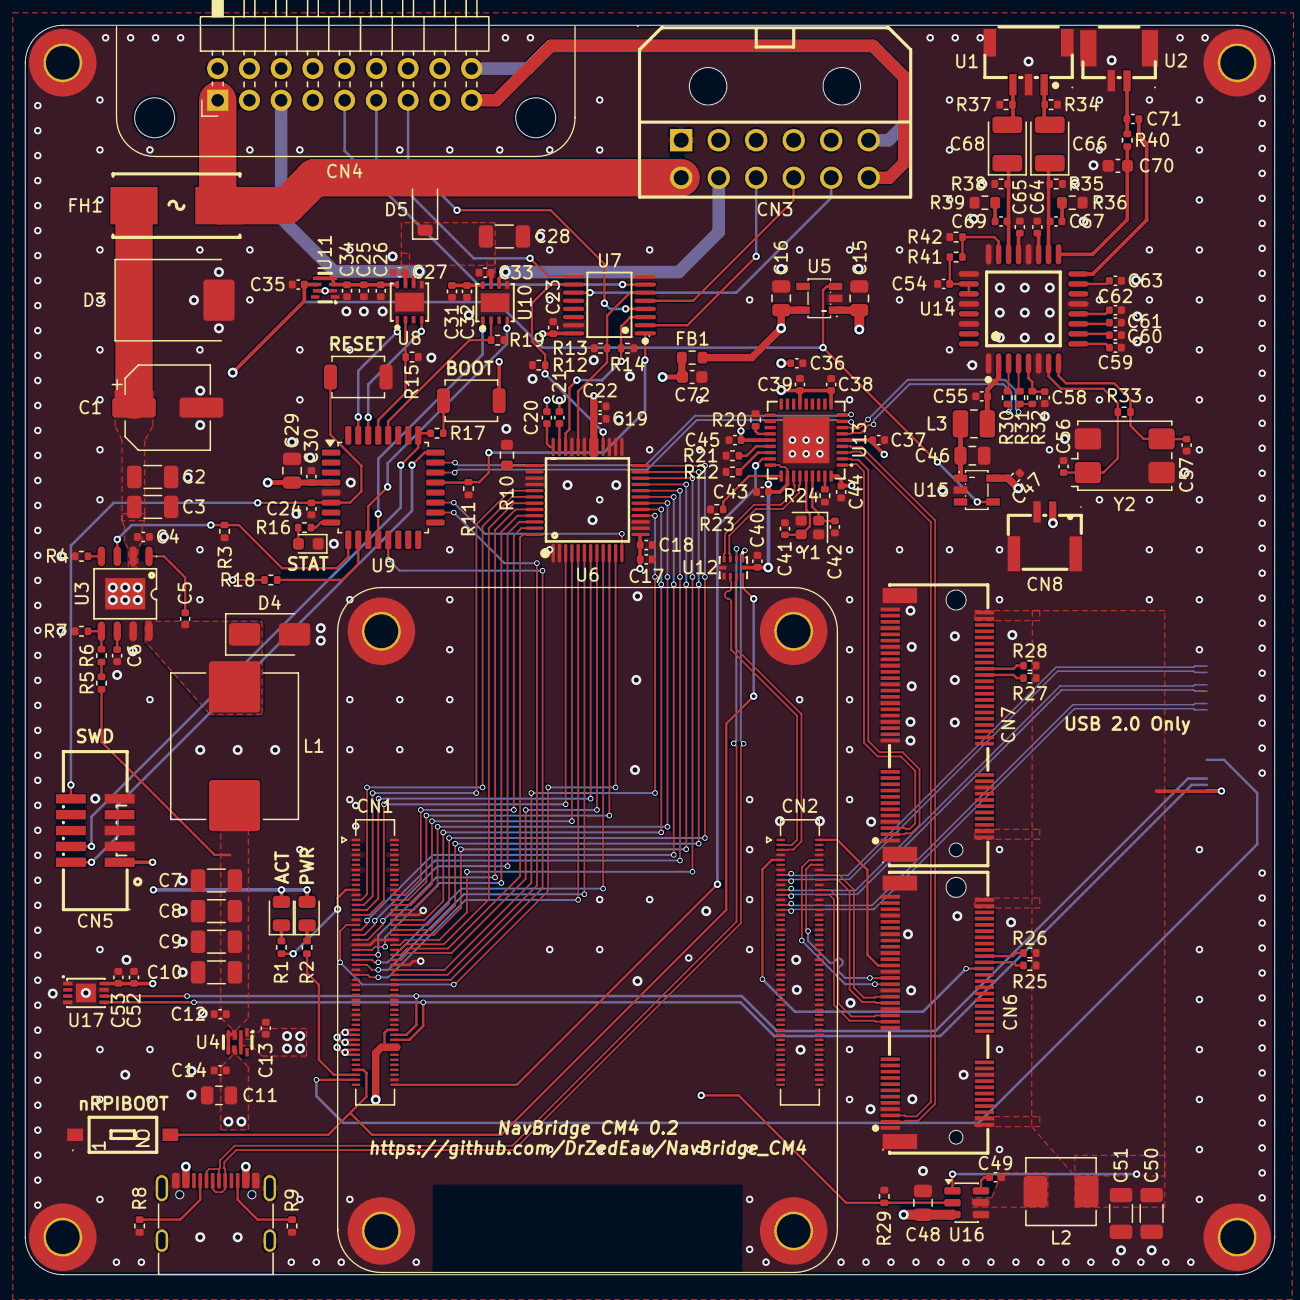
[picture p13: board NavBridge_CM4.kicad_pcb from above]

Board: 4 copper layers, 100.0 x 100.0 mm, 165 parts (1 on the bottom side), 157 nets.
