DrZedEau/NavBridge_CM4/(commit log)

2026-11-06 Add NavBridge CM4 revision 0.2
    - KiCad 10 project for revision 0.2 in hardware/NavBridge_CM4, with its
    project-local libraries (only the 3D models used on the board) and the
    JLCPCB fabrication files
    - New 3D renders of the board (angled, top and bottom)
    - READMEs updated for revision 0.2: two I-Bus transceivers, CSI camera
    connector, SWD connector, no SD card slot, new reference designators
    and MCU pin map
    - Ignore KiCad per-user files (.kicad_prl, .history)
    [Analog_RGB.kicad_sch, Audio.kicad_sch, M.2.kicad_sch, MCU_Lin.kicad_sch, Misc.kicad_sch, NavBridge_CM4.kicad_pcb, NavBridge_CM4.kicad_sch, Power.kicad_sch]
2026-11-08 fix LCSC part number for SW2
    [MCU_Lin.kicad_sch]
